TallesSantosCUBoulder/ECEN4638_Spring26_FinalProject_PID_Elevator/Figures/Screenshot 2026-05-10 at 10.23.55 PM.png

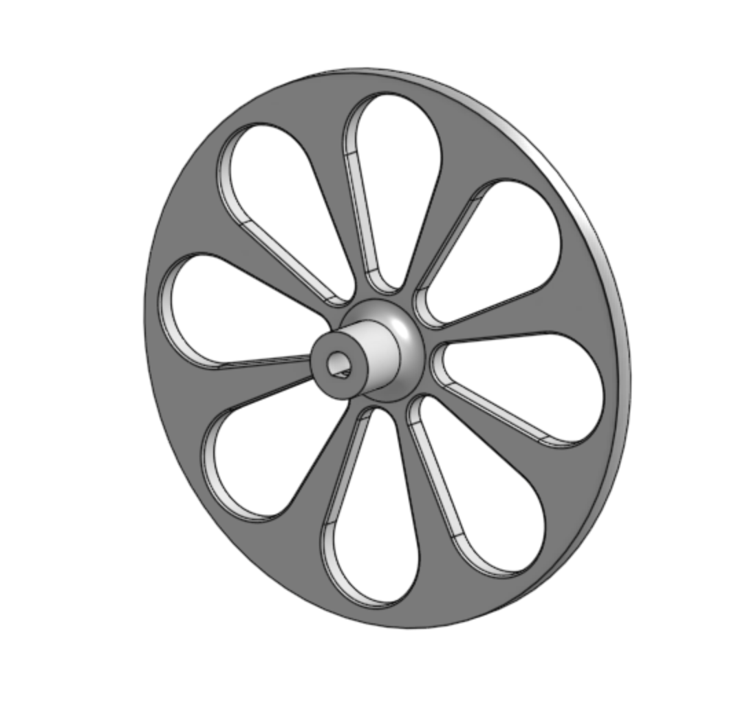
Figures/Screenshot 2026-05-10 at 10.23.55 PM.png
