TallesSantosCUBoulder/ECEN4638_Spring26_FinalProject_PID_Elevator/STL_Files/Spoke Wheel.stl

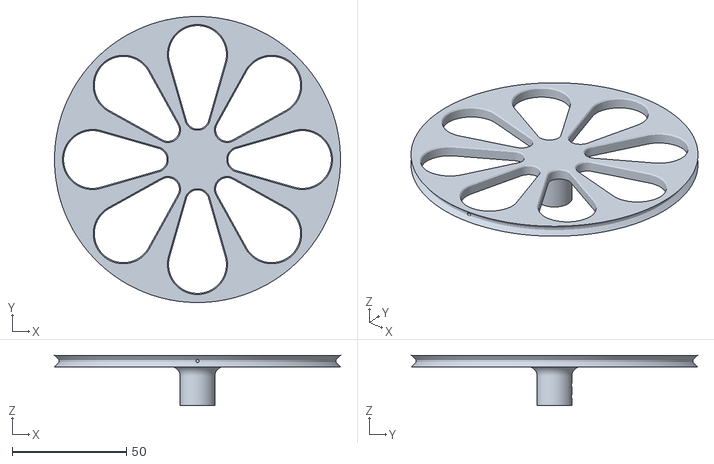
[picture p5: CAD file, 2026-05-11]
STL_Files/Spoke Wheel.stl
125.0 x 125.0 x 22.0
