TallesSantosCUBoulder/ECEN4638_Spring26_FinalProject_PID_Elevator/STL_Files/Cable Arch Guide.stl

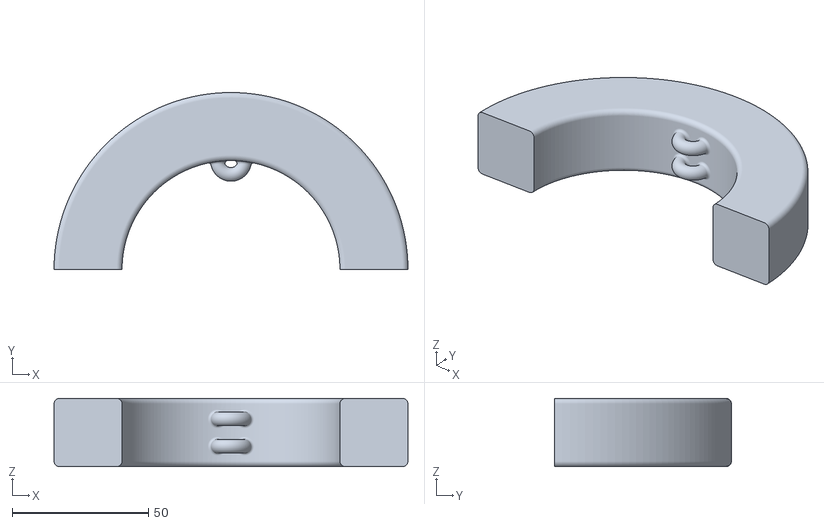
[picture p6: CAD file, 2026-05-11]
STL_Files/Cable Arch Guide.stl
130.0 x 65.0 x 25.0
