TallesSantosCUBoulder/ECEN4638_Spring26_FinalProject_PID_Elevator/STL_Files/DC Motor Housing - Bottom.stl

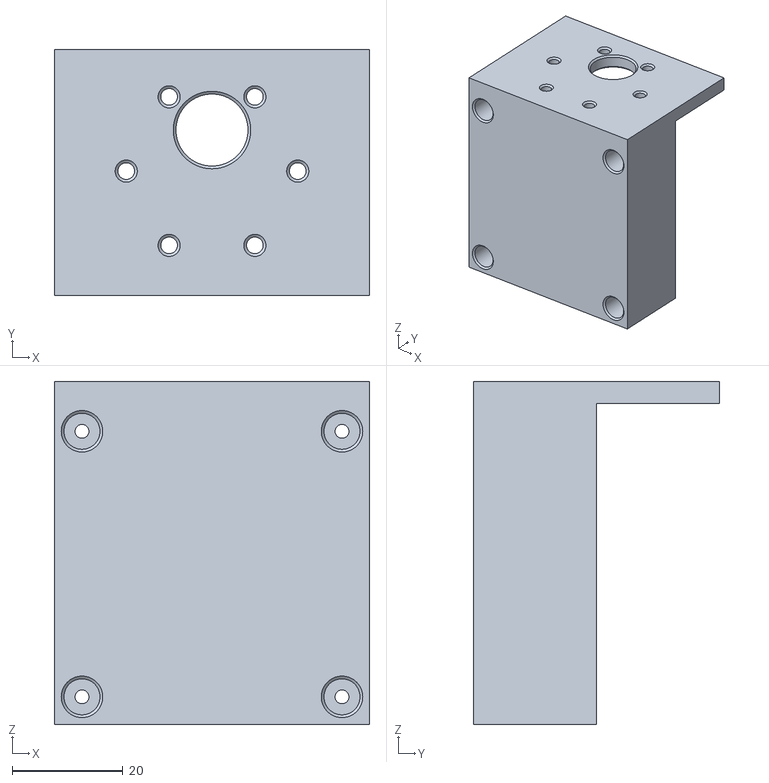
[picture p7: CAD file, 2026-05-11]
STL_Files/DC Motor Housing - Bottom.stl
57.0 x 44.5 x 62.0
