TallesSantosCUBoulder/ECEN4638_Spring26_FinalProject_PID_Elevator/STL_Files/DC Motor Housing - Top.stl

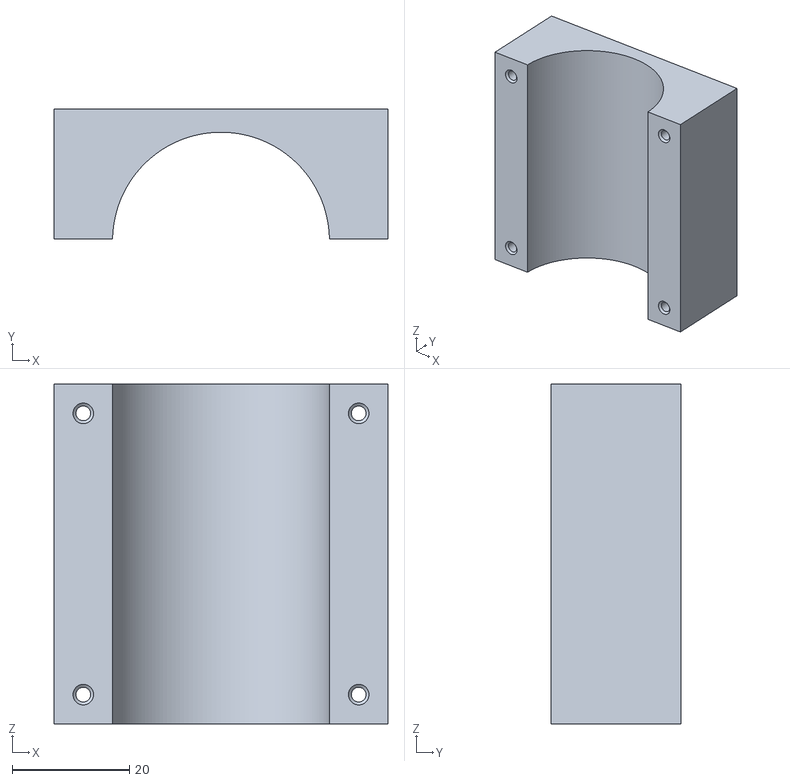
[picture p8: CAD file, 2026-05-11]
STL_Files/DC Motor Housing - Top.stl
57.0 x 22.2 x 58.0
